shackspace/blinken64/artwork/poster.pdf

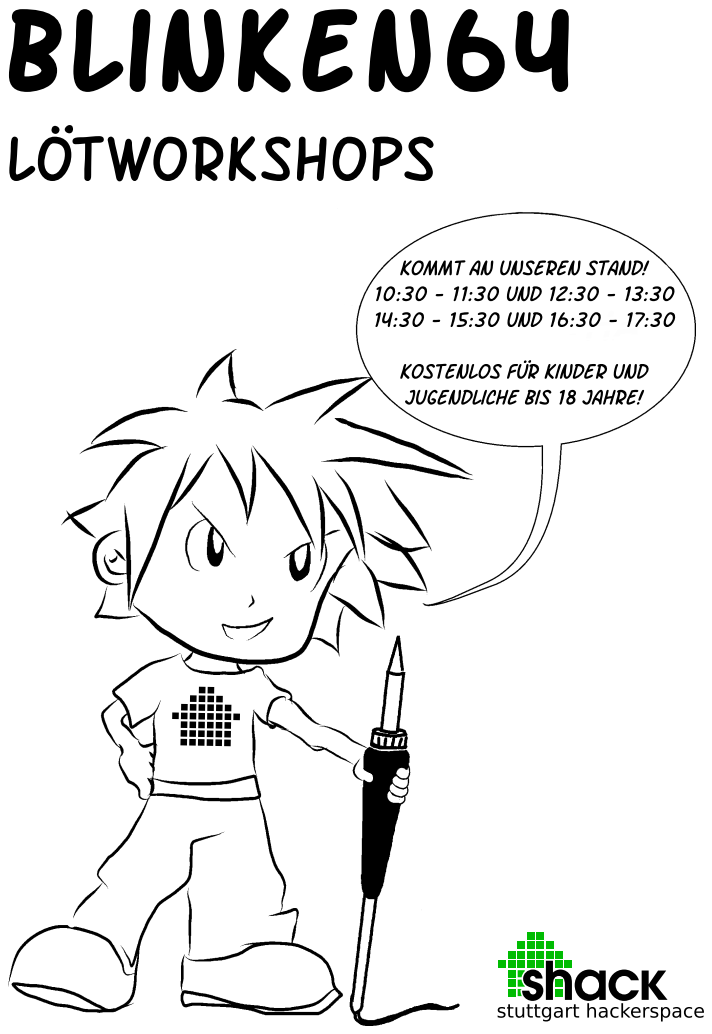
[picture p1: page 1]
