shackspace/blinken64/artwork/label.pdf

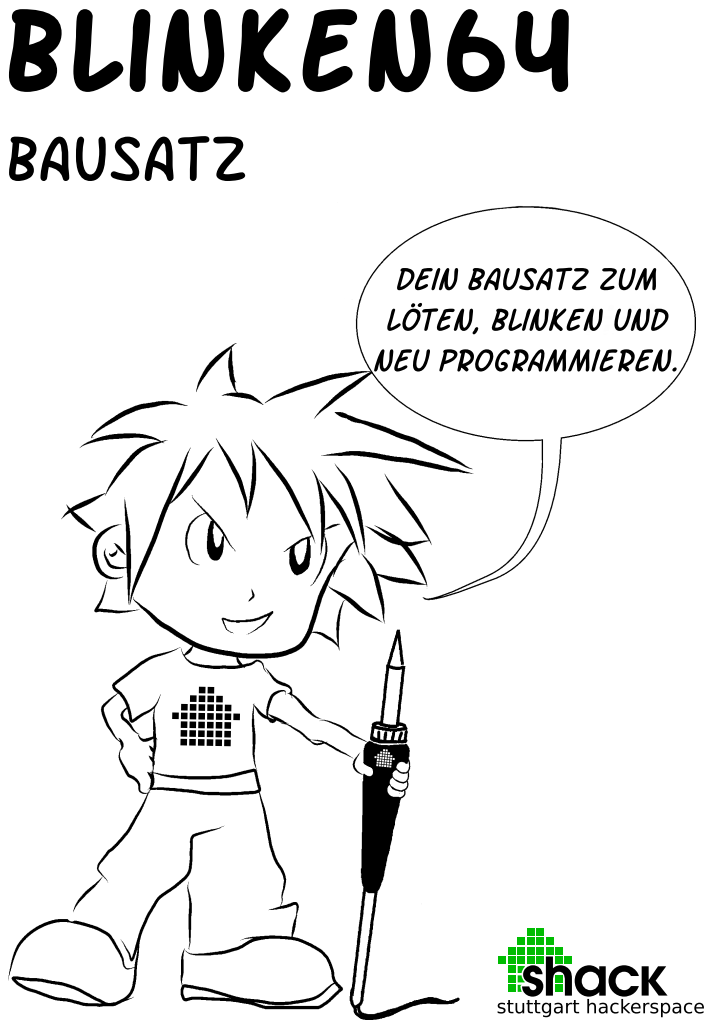
[picture p2: page 1]
