shackspace/blinken64/artwork/blinken64_aufbauanleitung1.png

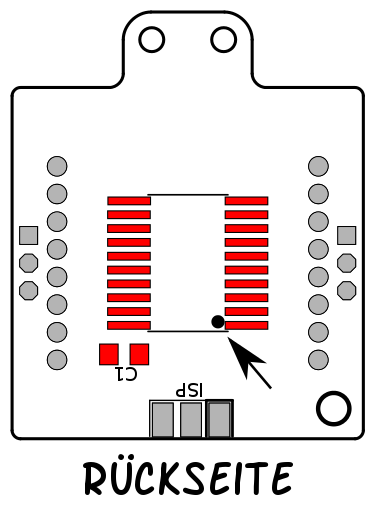
artwork/blinken64_aufbauanleitung1.png
