shackspace/blinken64/artwork/blinken64_aufbauanleitung3.png

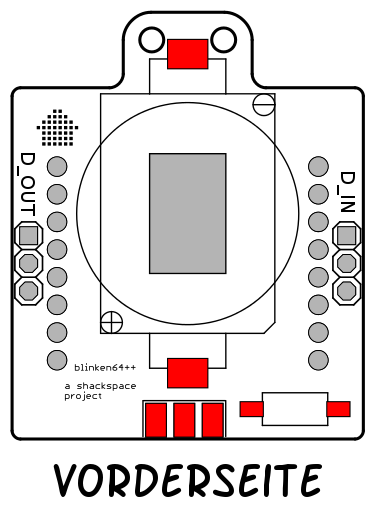
artwork/blinken64_aufbauanleitung3.png
