shackspace/blinken64/artwork/blinken64_aufbauanleitung4.png

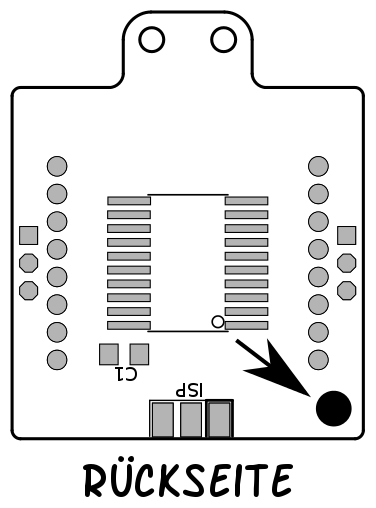
artwork/blinken64_aufbauanleitung4.png
