shackspace/blinken64/artwork/blinken64_aufbauanleitung5.png

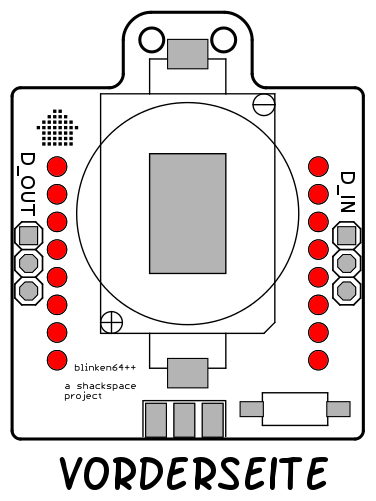
artwork/blinken64_aufbauanleitung5.png
