shackspace/blinken64/artwork/blinken64_aufbauanleitung6.png

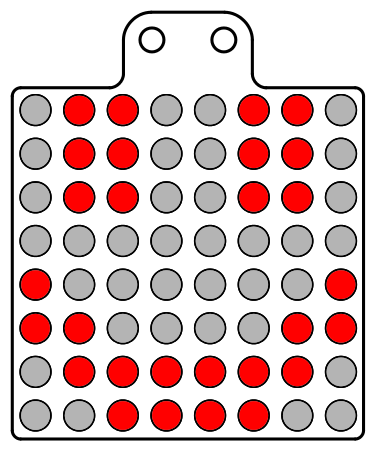
artwork/blinken64_aufbauanleitung6.png
