shackspace/blinken64/artwork/aufbauanleitung.pdf

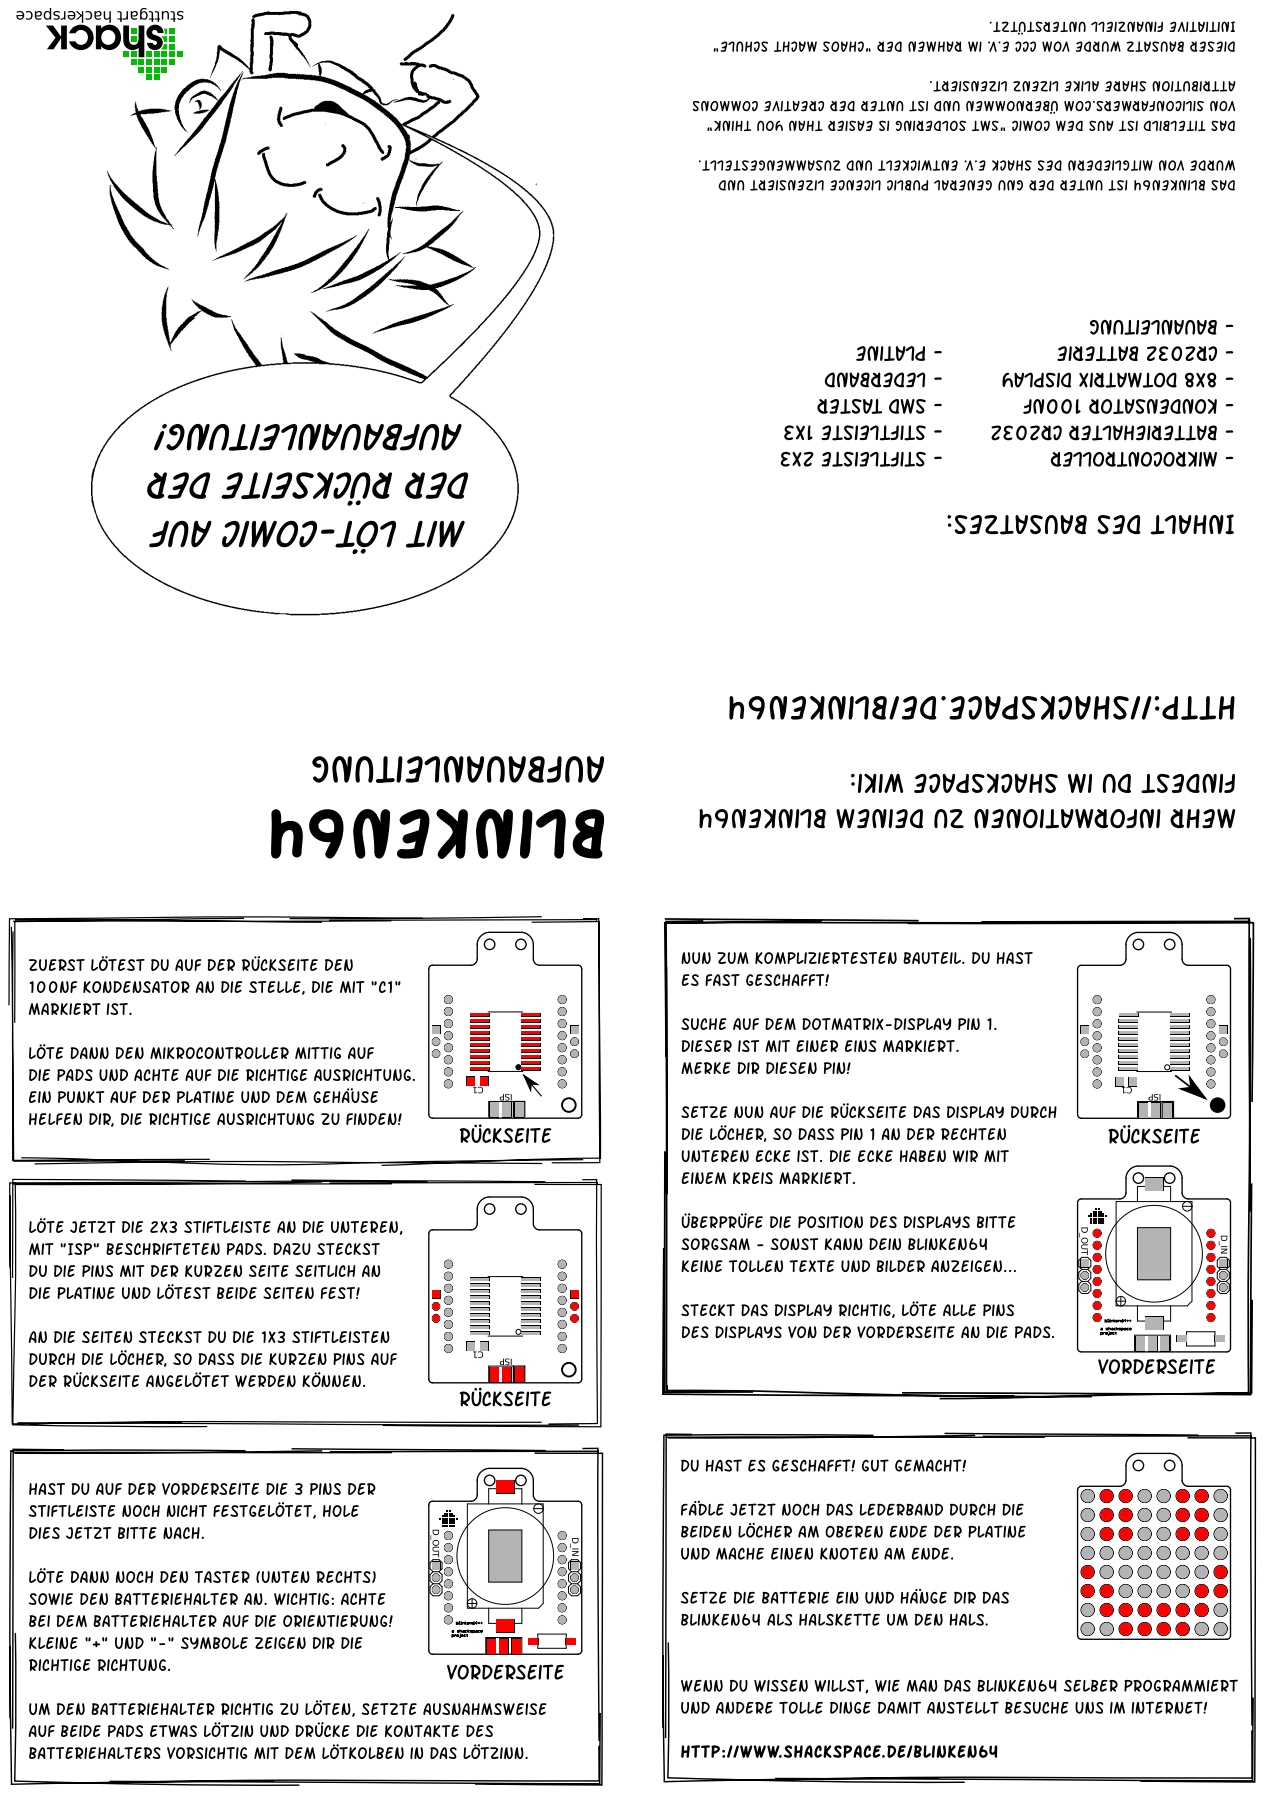
[picture p8: page 1]
