shackspace/blinken64/artwork/loetenlernanleitung.pdf

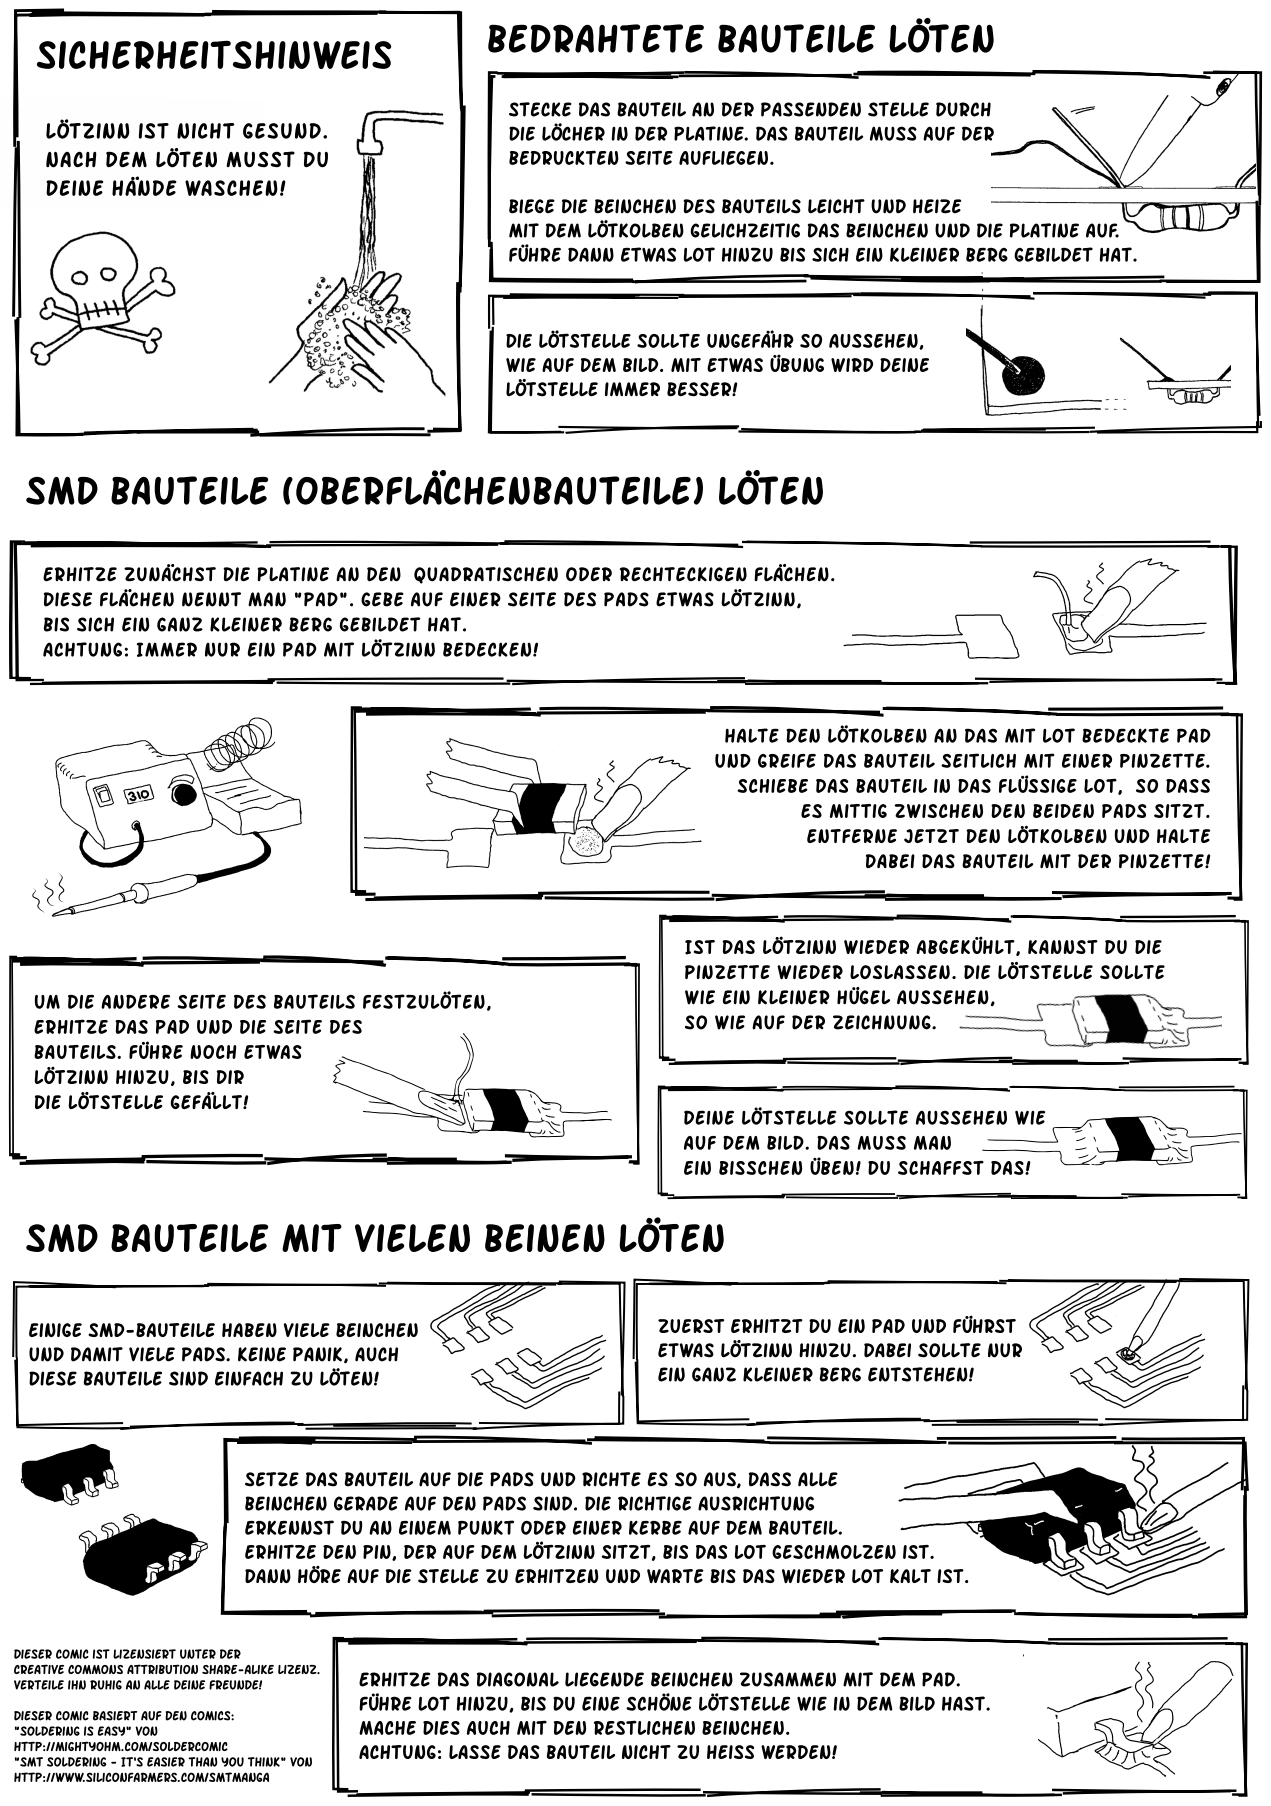
[picture p9: page 1]
