shackspace/blinken64/audio_connect/audioconnect.brd

## EAGLE design audio_connect/audioconnect.brd (2014-11-26)

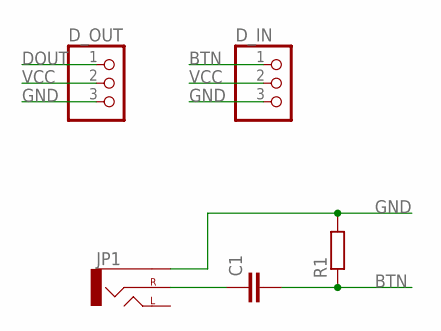
[picture p10: schematic audioconnect.sch]

Parts:
C1: C-EUC1206; C1206
D_IN: PINHD-1X03_2.54-S; 1X03-S
D_OUT: PINHD-1X03_2.54-S; 1X03-S
JP1: AUDIO-JACKPTH; AUDIO-JACK
R1: R-EU_R1206; R1206

Connections:
BTN: C1.2, D_IN.1, R1.1
DOUT: D_OUT.1
GND: D_IN.3, D_OUT.3, JP1.SLEEVE, R1.2
unnamed: C1.1, JP1.RING (RIGHT)
VCC: D_IN.2, D_OUT.2

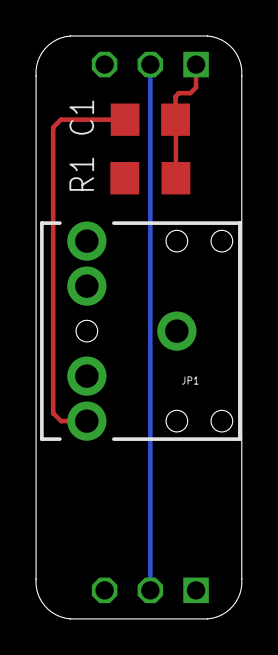
[picture p11: board audioconnect.brd from above]

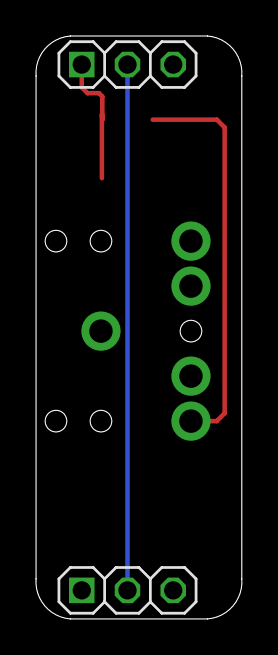
[picture p12: board audioconnect.brd from below]

Board: 2 copper layers, 11.4 x 32.4 mm, 5 parts (2 on the bottom side), 4 nets.
