shackspace/blinken64/schematic/shackEV_blinken64pp.brd

## EAGLE design schematic/shackEV_blinken64pp.brd (2014-11-26)

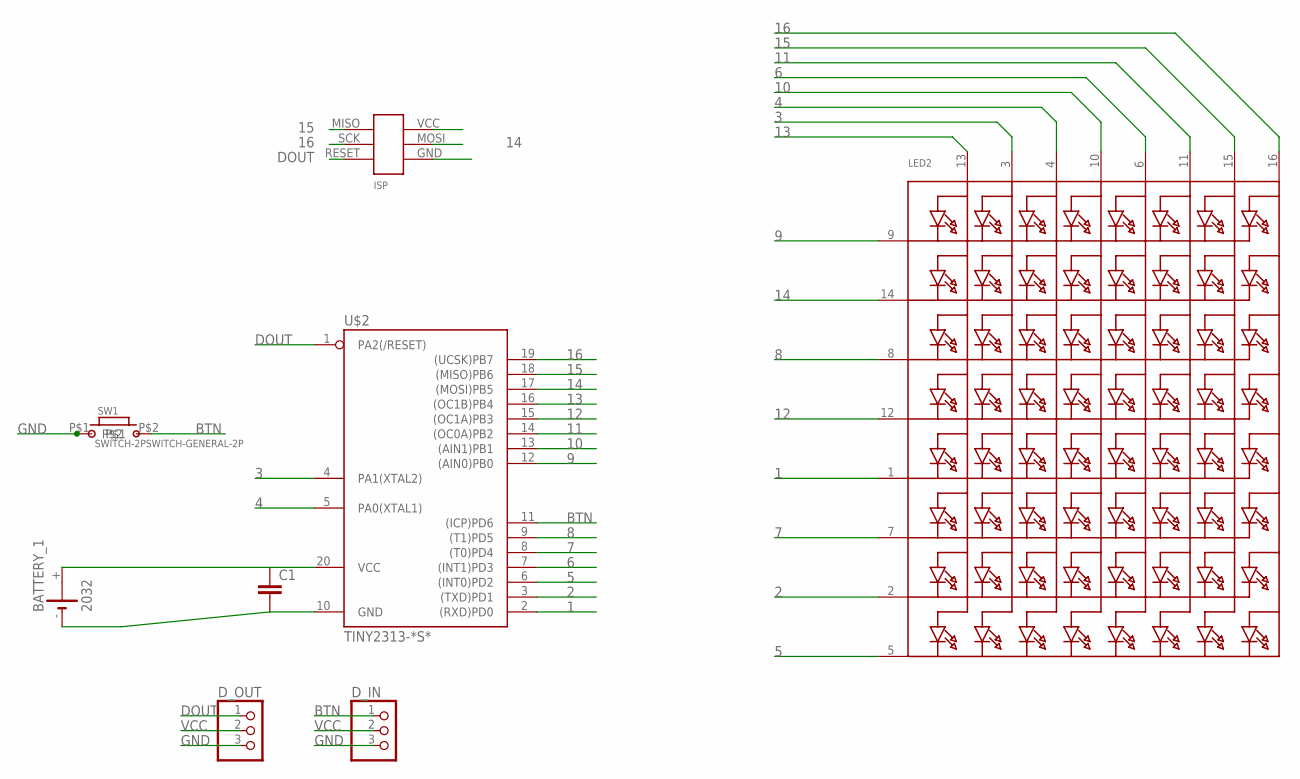
[picture p13: schematic shackEV_blinken64pp.sch]

Parts:
BATTERY_1: 2032; KZH20SMD
C1: C-EUC1206; C1206
D_IN: PINHD-1X03_2.54-S; 1X03-S
D_OUT: PINHD-1X03_2.54-S; 1X03-S
ISP1: SMD-ISP; SMD
LED2: MICROBUILDER_DISP_SEGMENT_8X8_ROWCATHODEM12A881UR; MICROBUILDER_SEGMENT_BL-M12A881UR
SW1: SWITCH-2PSWITCH-GENERAL-2P; 2P-SWITCH-GENERAL
U$2: TINY2313-*S*; SO20L$

Connections:
1: LED2.1 (K5), U$2.2 ((RXD)PD0)
2: LED2.2 (K7), U$2.3 ((TXD)PD1)
3: LED2.3 (A2), U$2.4 (PA1(XTAL2))
4: LED2.4 (A3), U$2.5 (PA0(XTAL1))
5: LED2.5 (K8), U$2.6 ((INT0)PD2)
6: LED2.6 (A5), U$2.7 ((INT1)PD3)
7: LED2.7 (K6), U$2.8 ((T0)PD4)
8: LED2.8 (K3), U$2.9 ((T1)PD5)
9: LED2.9 (K1), U$2.12 ((AIN0)PB0)
10: LED2.10 (A4), U$2.13 ((AIN1)PB1)
11: LED2.11 (A6), U$2.14 ((OC0A)PB2)
12: LED2.12 (K4), U$2.15 ((OC1A)PB3)
13: LED2.13 (A1), U$2.16 ((OC1B)PB4)
14: ISP1.MOSI, LED2.14 (K2), U$2.17 ((MOSI)PB5)
15: ISP1.MISO, LED2.15 (A7), U$2.18 ((MISO)PB6)
16: ISP1.SCK, LED2.16 (A8), U$2.19 ((UCSK)PB7)
BTN: D_IN.1, SW1.P$2, U$2.11 ((ICP)PD6)
DOUT: D_OUT.1, ISP1.RESET, U$2.1 (PA2(/RESET))
GND: BATTERY_1.-, C1.2, D_IN.3, D_OUT.3, ISP1.GND, SW1.P$1, U$2.10 (GND)
VCC: BATTERY_1.+, C1.1, D_IN.2, D_OUT.2, ISP1.VCC, U$2.20 (VCC)

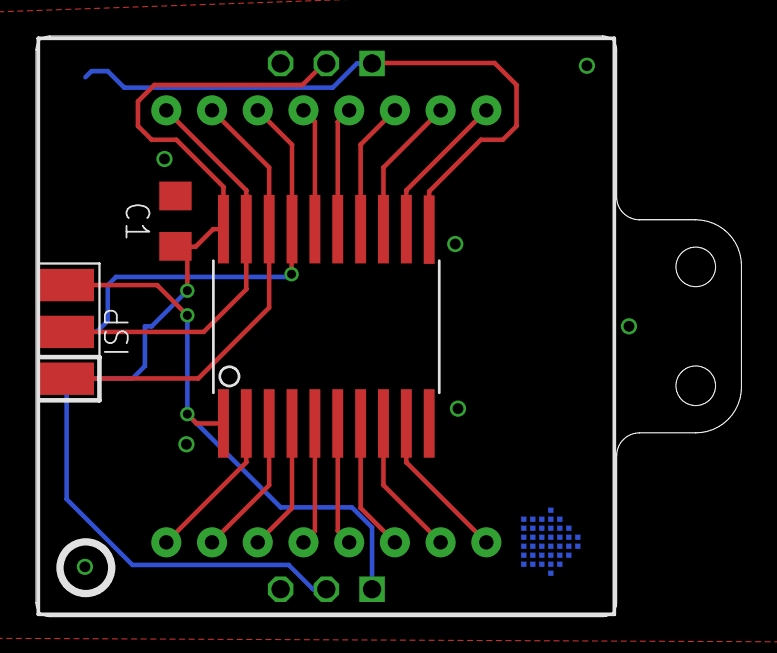
[picture p14: board shackEV_blinken64pp.brd from above]

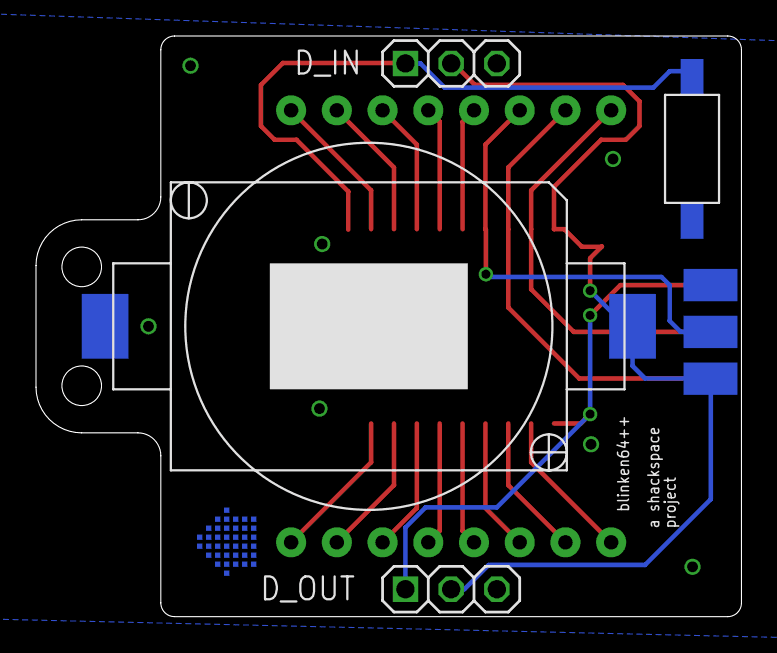
[picture p15: board shackEV_blinken64pp.brd from below]

Board: 2 copper layers, 39.2 x 32.3 mm, 8 parts (4 on the bottom side), 20 nets.
