shackspace/blinken64/(commit log)

2014-11-26 This commit add the files from http://nomnom.de/projects/blinken64/blinken64.zip This is the first blinken64V1 version more information: http://shackspace.de/wiki/doku.php?id=project:blinken64v1
2014-11-26 Add new branch with current version
    [audioconnect.brd, audioconnect.sch, shackEV_blinken64pp.brd, shackEV_blinken64pp.sch]
